OH1KH/WiFiCat/ISR_CW/README.md

Kenwood TS50s cat interface with ESP12e WiFi

TODO:

	For both programs: Make ISR based CW.
	Now rig polling will interrupt iambic keying. And Text to CW commands will stop rig 
	polling during CW output. Bad!
