OH1KH/WiFiCat/doc/TS-50shematic.pdf

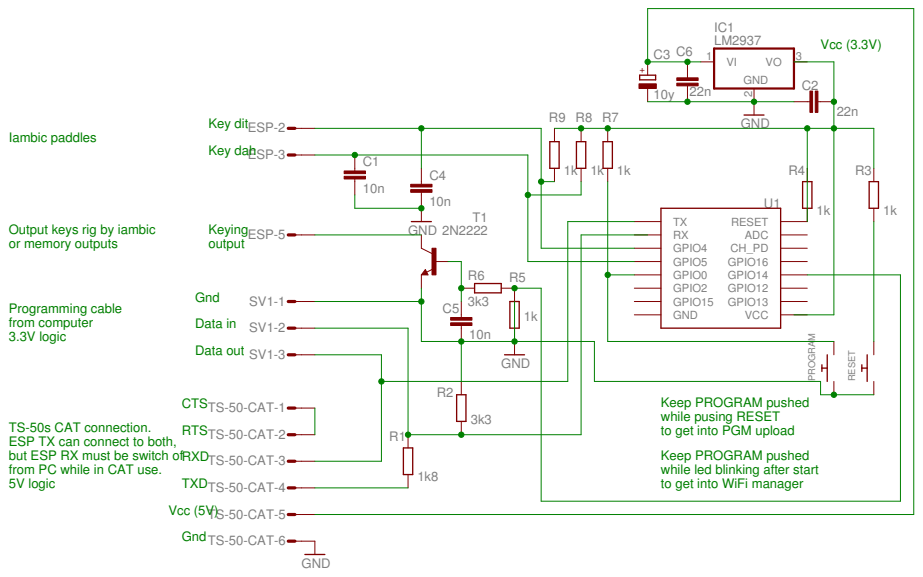
[picture p7: page 1]

Output keys rig by iambic or memory outputs

Gnd
Data in Data out

Programming cable
from computer 3.3V logic TS-50s CAT connection. ESP TX can connect to both, but ESP RX must be switch of

CTS
TS-50-CAT-1
RTS
TS-50-CAT-2
RXD
TS-50-CAT-3
to get into WiFi manager Gnd
TS-50-CAT-4
Vcc (5V)
TS-50-CAT-5
TS-50-CAT-6

Keep PROGRAM pushed while pusing RESET
to get into PGM upload
