OH1KH/WiFiCat/TS50v2/led_cw.ino

void led_R() {
      digitalWrite(OnBoardLed, LedOff); 
      delay(2000);
      digitalWrite(OnBoardLed, LedOn);
      delay(200);
      digitalWrite(OnBoardLed, LedOff);
      delay(200);
      digitalWrite(OnBoardLed, LedOn);  //CW R
      delay(600);
      digitalWrite(OnBoardLed, LedOff);
      delay(200);
      digitalWrite(OnBoardLed, LedOn);
      delay(200);
      digitalWrite(OnBoardLed, LedOff);
      delay(1000);
}

void led_N() {
      digitalWrite(OnBoardLed, LedOff); 
      delay(2000);
      digitalWrite(OnBoardLed, LedOn);  //CW N
      delay(600);
      digitalWrite(OnBoardLed, LedOff);
      delay(200);
      digitalWrite(OnBoardLed, LedOn);
      delay(200);
      digitalWrite(OnBoardLed, LedOff);
      delay(1000);
}
void led_I() {
      digitalWrite(OnBoardLed, LedOff); 
      delay(1000);
      digitalWrite(OnBoardLed, LedOn);
      delay(200);
      digitalWrite(OnBoardLed, LedOff); // CW_I
      delay(200);
      digitalWrite(OnBoardLed, LedOn);
      delay(200);
      digitalWrite(OnBoardLed, LedOff);
      delay(1000);
}
